MultipedRobotics/multiped/docs/readme.md

# Docs

**work in progress**

## AX-12A Quadruped

All current efforts is going into this version.

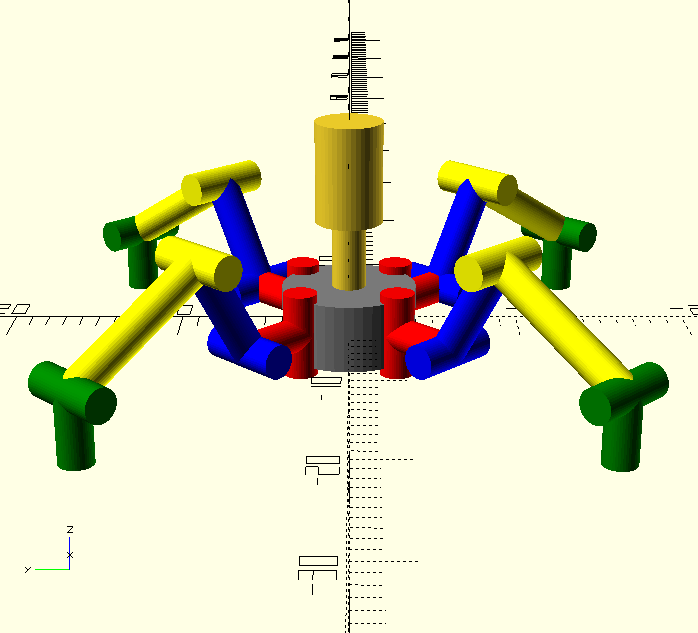
[picture p5: docs/quad-4-links.png]


## XL-320 Quadruped

**work pretty much abandoned**

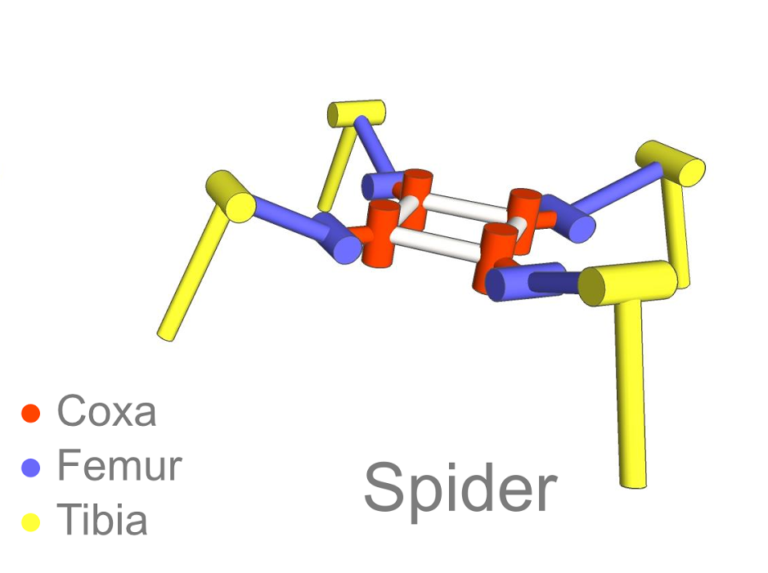
[picture p6: docs/spider.png]
