MultipedRobotics/multiped/docs/misc/readme.md

# Documentation

**This is still a work in progress**

This folder contains most of the documentataion for this robot. Other documents would
include the libraries used:

- [mote](https://github.com/MomsFriendlyRobotCompany/mote): how the RPi software was setup
- [opencvutils](https://github.com/MomsFriendlyRobotCompany/opencvutils): for the pi camera
- [xl-320](https://github.com/MomsFriendlyRobotCompany/pyxl320): the servos used in the legs
- [ins_nav](https://github.com/MomsFriendlyRobotCompany/ins_nav): navigation software
- [nxp_imu](https://github.com/MomsFriendlyRobotCompany/nxp_imu): inertial measurement unit
- [mcp3208](https://github.com/MomsFriendlyRobotCompany/mcp3208): analog to digital converter
- [fake_rpi](https://github.com/MomsFriendlyRobotCompany/fake_rpi): library to emulate the RPi when testing on different hardware (like my macbook)

## Documentation Here

- Markdown: documentation about this robot that is not already covered above
- ipython: jupyter notebooks for software development

Other folders contain various information
