MultipedRobotics/multiped/docs/misc/walking-robots-pdfs/equations-for-hexapod-robot-control.pdf

Equations for hexapod robot control | www.hexapod-kit.com

# Equations for Hexapod robot control

Determine joints angles according to the position of leg tip. A method for linear interpolation (straight walk).
A method for circular interpolation (curved walk).
A method for body inclination (tilt).

Determine joints angles according to the position of leg tip.

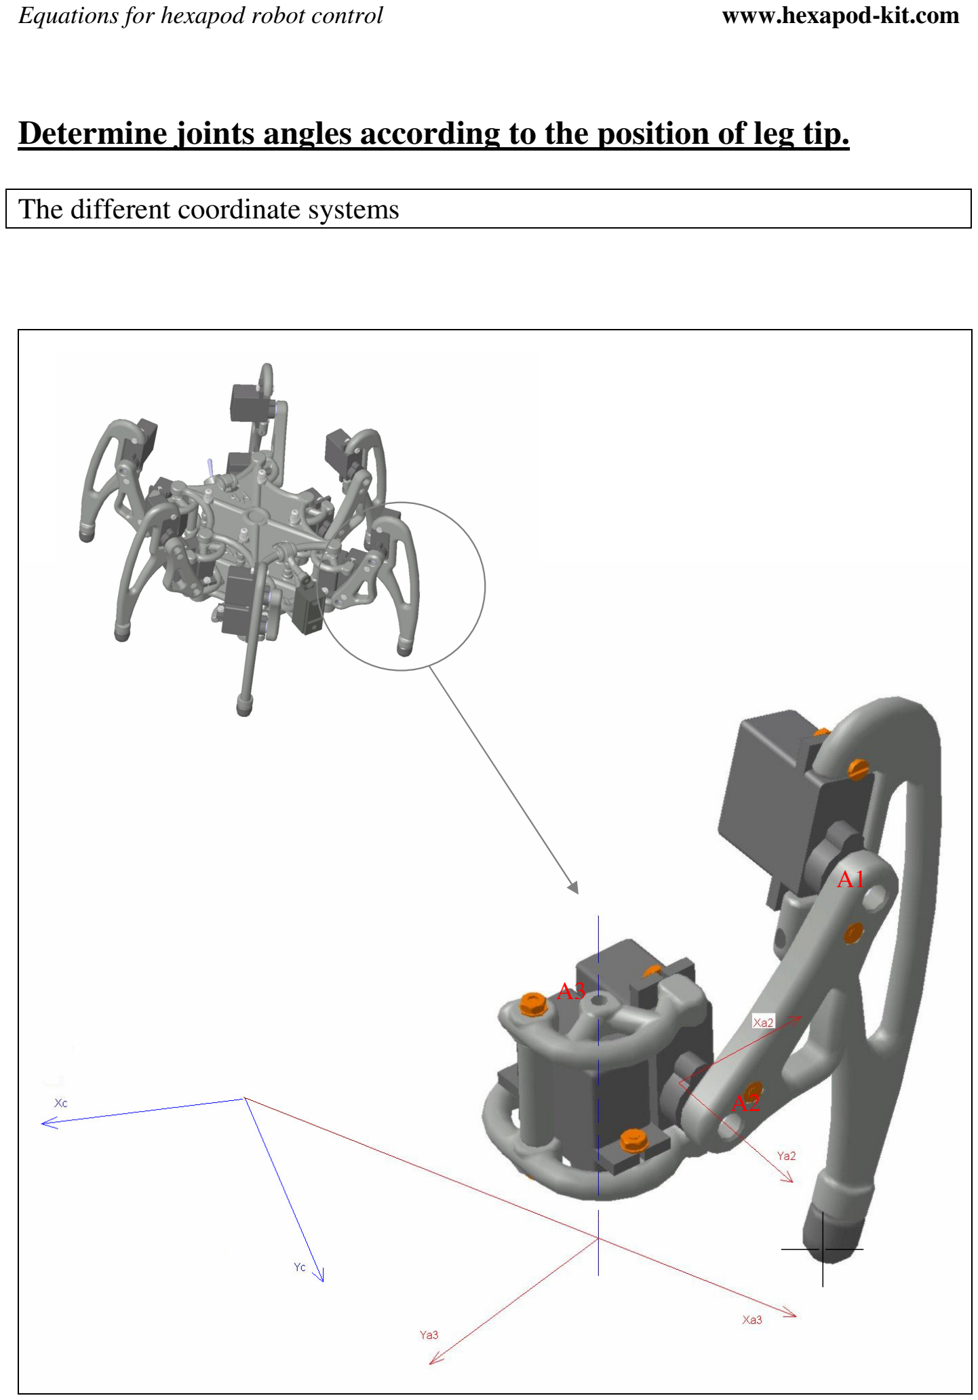
[picture p13: page 2]

The different coordinate systems

A1

A2

A3

We want to drive the tip of a leg by its coordinates in a Cartesian coordinate system.
For reasons of simplicity, we express the coordinates in a fixed coordinate system centred on the body of the hexapod.
To calculate the angles to be applied to the three joints of the leg we have to use different coordinate systems, either fixed or movable relative to the body.
All angle measurements in formulas are expressed in radians.
- Coordinate systems fixed to the body c et a3 :

Seen from above

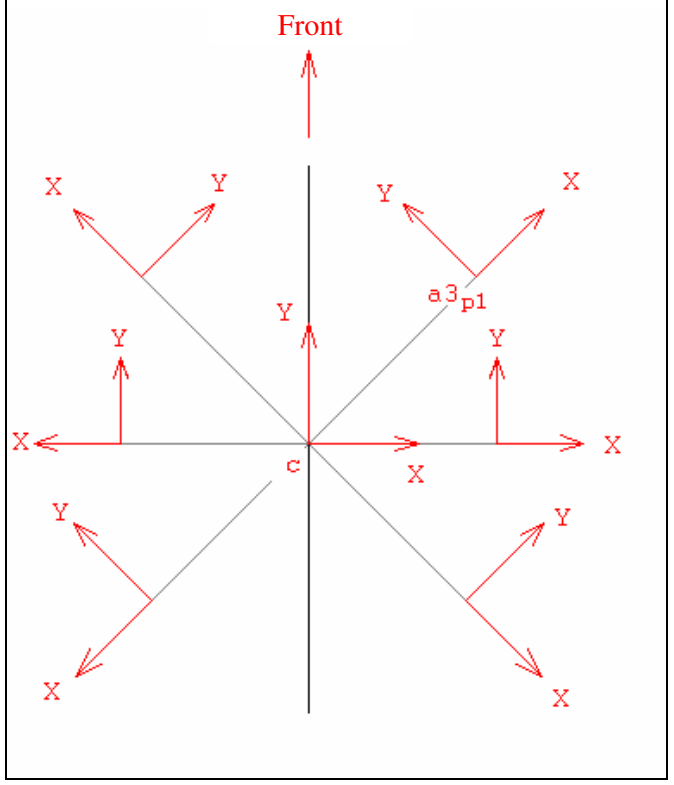
[picture p14: figure]
Front

System c is centred on the robot body. The plan [XY] of the system coincides with the underside of the body (the lowest point).
Systems a3px are centred on A3 joints of each leg.

- Coordinate systems movable relative to the body a2:

Seen top

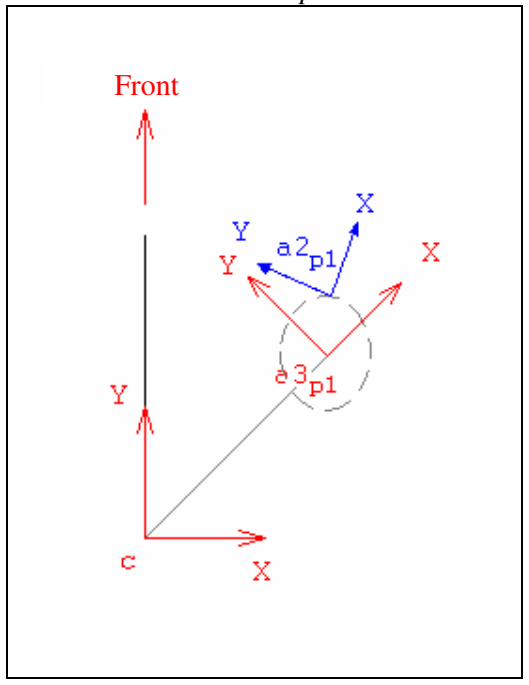
[picture p15: figure]
Front

Joints A2 and A1 in the [XZ] plan of coordinate system a2 :

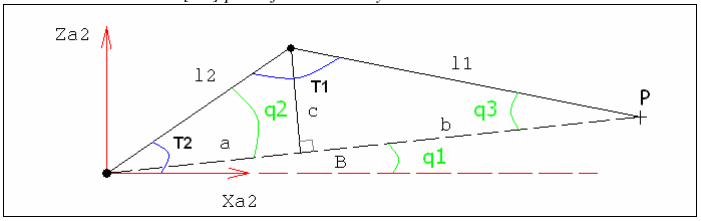
[picture p16: figure]

Given :

- l1et l2 respectively the lengths of the extreme and middle phalanxes.
- T1 angle between the extreme phalanx and middle phalanx.
- T2 angle between X axis and the middle phalanx.
- q1 angle between the axis X and B imaginary line passing through the joint centre A2 and the point P.
- q2 angle between B and the middle phalanx.
- q3 angle between B and the extreme phalanx.

B = a + b
2 | 2 | 2 B = Pxa2 + Pza2

2

cos( )2
l

a
q =

T 2 = q1+ q2

Find T2

B

B | l | l
a
B | aB | l | l
a | B | a | aB | l | l
a | B a | l | l
a | b | l | l
b | l | c
a | l | c

2

2 1

2 | 2 | 1
( | 2 | ) | 2 | 1
( | ) | 2 | 1

2 1

1

2

2 | 2 | 2
2 | 2 | 2
2 | 2 | 2 | 2 | 2
2 | 2 | 2 | 2
2 | 2 | 2 | 2
2 | 2 | 2
2 | 2 | 2
+ | −
=
− | + | = | −
− | + | − | = | −
− | − | = | −
− | = | −
= | −
= | −
l | B
B | l | l
q
2* 2*

2 1
cos( )2
2 | 2 | 2
+ | −
= | )
2

2
) arctan(
2* 2*

2 1

### 2 arccos(

2 | 2 | 2

Pxa

Pza
l | B
B | l | l
T | +
+ | −
=

)
2

2

### 1 arctan(

Pxa

Pza
q =

B

B | l | l
a
| 2 | 2 1
2 | 2 | 2
+ | −
=

cos(a −b) = cos(a)cos(b) + sin(a)sin(b)

Find T1

2 1 2

2 1
2 1 2
2 2 | 2 | 1
cos( )1
| | 2 1 2 2 2
2 1 2
| 2 1
cos( )1

1 2 1 2

2
1 2

2
cos( )1

1 2

2 | ( ( | ))
2
2 | ( | )
cos( )1

1 2

2
1 2

cos( )1

1 1 2

*
2

cos( )1

1 1 2

*
2

cos( )1

1 1 2

1
*
2

2
cos( )1

1 1 2

* 1
2

cos( )1 1

1 2

))
1

*) arcsin(
2

cos( )1 cos(arcsin(

)
1

) arcsin(
2

### 1 arcsin(

) )
1

) arcsin(
2

1 ( arcsin(

)
1

) arccos(
2

### 1 arccos(

1 | 2 | 3
2 | 2 | 2 | 2 | 2 | 2 | 2
2 | 2 | 2 | 2

2 2

2

2

2 2

2 | 2 | 2

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
l | l | B
l l
l | B | l | l
T

ll

l
ll
B | l | l
T

ll

aB
ll

l
ll

l aB T

ll

l a a b
l
l | a | ab T

ll

l | a | ab
ll

c ab T

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
T | q | q
+ | −
=
− | − | +
=
| | +
+ | −
= −
= | −
− | +
= −
− | + | +
= −

− −
=

− +
=

+
=
= | +
= | +

+

− | −
=
= | − | − | +
= | +
= | −
= | − − | + | +
= | − | −
= | − | −
π | π

π

π

)
2 1 2

1 2

### 1 arccos(

2 | 2 | 2

l l

l | l | B
T

+ −
=

Find joint angle A3 (T3)

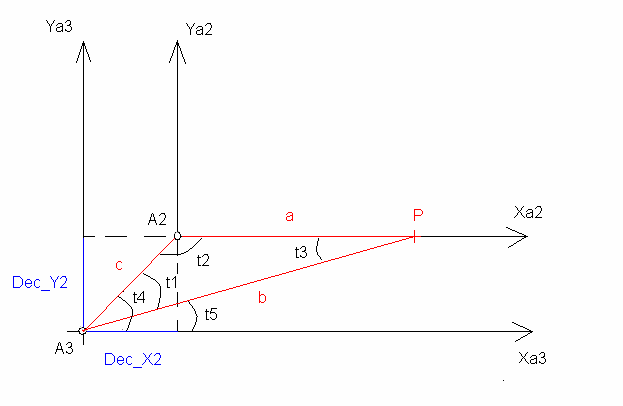
[picture p17: figure]

- Dec_X2 is the offset on X axis, between joints A3 et A2.
- Dec_Y2 is the offset on Y axis, between joints A3 et A2.
- Dec_Z2 is the offset on Z axis, between joints A3 et A2 (=0).
- Given a the projection on Xa2 of the imaginary line B (seen previously).

2 2

2 2

3 3

)
_ 2

_ 2
arctan(
2

2

_ 2 | _ 2
b | Pxa | Pya Dec Y

Dec X
t
c | Dec X | Dec Y
= | +
= | +
= | +

π

We know that :

sin( )1 | sin( )2 | sin(t )3 c
| t

b
t

a
= | = | Sinus proportionality rule.

So :

sin( )2 | cos( )2 )

sin( )2
1 2 arcsin(

)

sin( )2

### 3 arcsin(

2 | 2 | 2
a | b | c | t | c | t

b

c | t
t | t

b

c t
t
= | − | × | + ×

×
= | − | −
| | ×
=

π

2 | sin( )2 | cos( )2
2 | 2 | 2 Pxa = Bx = b − c × | t | + c × | t

Pya2 = 0

)
3

3

### 5 arctan(

)

sin( )2

### 1 arcsin(

)
_ 2

_ 2

### 4 arctan(

Pxa

Pya
t

b

a t
t

Dec X

Dec Y
t

=

×
=

=

Given T3 the angle of the joint A3, we have :

T3 = t5 + t1− t4

Change of coordinate system (system c to a3)

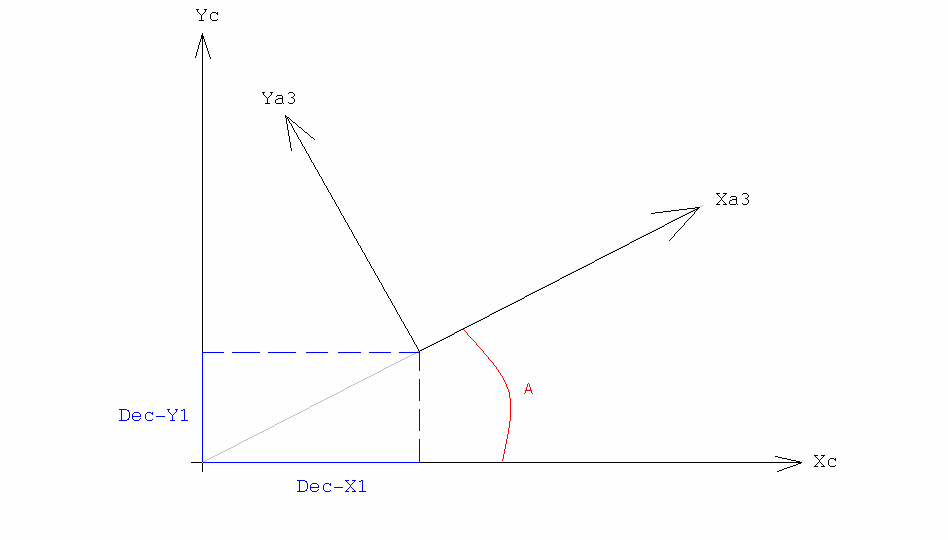
[picture p18: figure]

- System a3 is centred on A3 joint.
- System c is centred on the hexapod body (Y axis pointing to the front of the hexapod).
- A is the angle between X axis of the body centred system and the X axis of the A3 joint centred system.
- Dec_X1 is the abscissa of a3 system centre, expressed in the c system.
- Dec_Y1 is the ordinate of a3 system centre, expressed in the c system.
- Dec_Z1 is the altitude of a3 system centre, expressed in the c system (=0).

A, Dec_X1, Dec_Y1 et Dec_Z1 are not the same for all legs.

3 | ( | cos( ) | sin( ))
3 | cos( ) | sin( ) | _ 1 | _ 1

2 2

Pya | Pyc | A | Pxc | A
Pxa | Pxc | A | Pyc | A | DEC X | DEC Y
= − | × | − | ×
= | × | + | × | − | +

Sum up

Coordinate system c to a3 :

### 3 _ 1

3 | ( | cos( ) | sin( ))
3 | cos( ) | sin( ) | _ 1 | _ 1

2 2

Pza | Pzc Dec Z
Pya | Pyc | A | Pxc | A
Pxa | Pxc | A | Pyc | A | DEC X | DEC Y
= | −
= − | × | − | ×
= | × | + | × | − | +

Coordinate system a3 to a2 :

2 | 3 | _ 2

2 0

2 | sin( )2 | cos( )2
| ) _ 2

_ 2
arctan(
2

2

3 3

_ 2 | _ 2
2 | 2 | 2

2 2

2 2

Pza | Pz | Dec Z

Pya

Pxa | Bx | b | c | t | c | t
| | | Dec Y

Dec X
t
c | Pxa | Pya
b | Dec X | Dec Y
= | −

=

= | = | − | × | + ×
= | +
= | +
= | +

π

Joints angles :

2 2 B = Pxa2 + Pza2

)
2 1 2

1 2

### 1 arccos(

2 | 2 | 2

l l

l | l | B
T

+ −
=

)
2

2
) arctan(
2* 2*

2 1

### 2 arccos(

2 | 2 | 2

Pxa

Pza
l | B
B | l | l
T | +
+ | −
=

)
_ 2

_ 2
) arctan(
3 3

))
_ 2

_ 2
arctan(
2

sin(
) arcsin(
3

3

### 3 arctan(

2 | 2 | Dec X Dec Y
Pxa | Pya
| Dec Y

Dec X
a

Pxa

Pya T | −

+

× | +
= | +

π

A method for linear interpolation (straight walk).

Straight walking consist in moving with a given distance in a given direction with a given step.

The three method parameters are :

L : The distance.
A : Angle between walking direction and the longitudinal axis of the hexapod (Yc). P : The unitary step of the leg (linear distance made in one walking cycle).

Another parameter is also used :

G : The ground clearance (body to ground distance).

Example for leg n°1

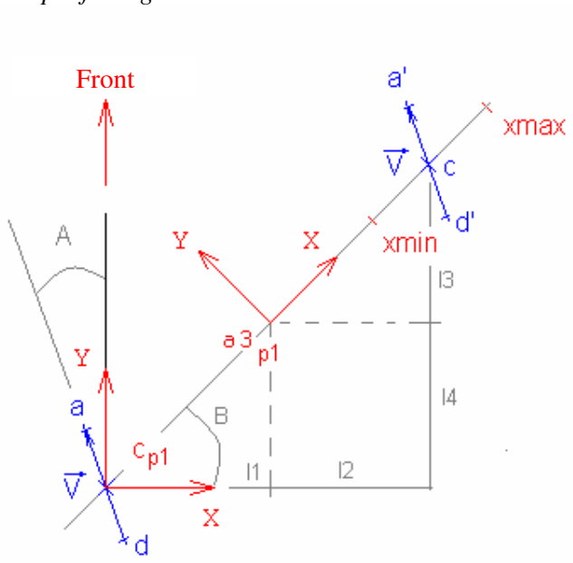
[picture p19: figure]
Front

Given V

r
the vector which norm is equal to L, and which angle with Yc axis is A .

### 4 _ 1

)
2

max min 3 sin( ) ( min

)
2

max min 2 cos( ) ( min

### 1 _ 1

l | Dec Y
x | x
l | B | x
x | x
l | B | x
l | Dec X

=

−
= | × | +

−
= | × | +

=

Coordinates of starting and arrival points d et a expressed in cp1 system.

dy | ay
dx | ax

L
ay | A

L
ax | A

= −

= −

= | ×
= − | ×

2

cos( )

2

sin( )

Coordinates of starting and arrival points d’ et a’ translated on c point expressed in cp1 system.

' | 3 | 4
' | 1 | 2
' | 3 | 4
' | 1 | 2
d y dy l | l
d x dx l | l
a y ay l | l
a x ax l | l
= | + | +
= | + +
= | + | +
= | + +

Then, we are able to calculate the values of the different joints for starting and arrival point thanks to the previous formulas.

Remarks :

Leg movement vector points in the opposite direction to the wanted body movement vector.

Number of cycles to be performed to reach the distance is equal to
P

L

In cp1 system Z coordinate of the leg tip is equal to –G.

A method for circular interpolation (curve walk).

Curve walking consists in moving of a given angle on a circle of given centre with a given step.

The three method parameters are :

A : Rotation angle.
C(xc;yc) : Coordinates of the rotation centre.
P : Unitary step of the leg (linear distance made in one walking cycle).

Another parameter is also used :

G : The ground clearance (body to ground distance).

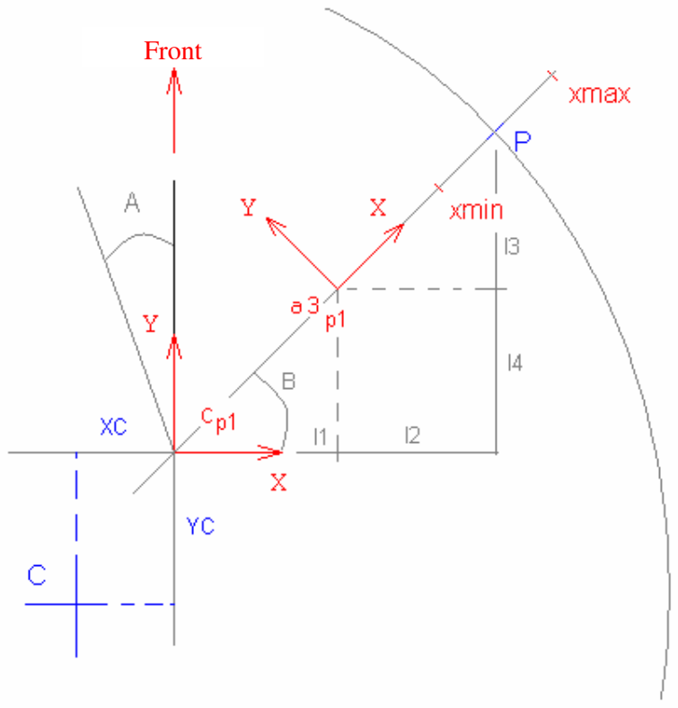
[picture p20: figure]
Front

### 4 _ 1

)
2

max min 3 sin( ) ( min

)
2

max min 2 cos( ) ( min

### 1 _ 1

l | Dec Y
x | x
l | B | x
x | x
l | B | x
l | Dec X

=

−
= | × | +

−
= | × | +

=

Compared to straight walking not all legs have the same movement vector. For a given unitary angular step, the farthest leg from the rotation centre will describe the longest distance in one walking cycle (Equal to P in our case).

At first we have to determine which leg is the farthest from the rotation centre.
For each leg we calculate the length of CP segment :
( | ) ( | ) ² | 2
CP = | l1+ l2 − XC + l3 + l4 −YC

For the leg which have the maximal CP, we calculate the angle T represented by points a and d spaced of a distance P, belonging to the circle.

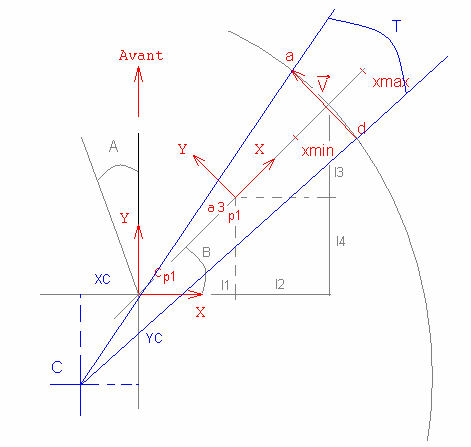
[picture p21: figure]

CP

P
T

Circ

P
T
Circ | CP

=

× ×
=

= × ×

π

π
2

2

T will be the unitary angular step for all legs in order to respect the unitary linear step P.

In the coordinate system centred on the cercle we express :

- The angle between the starting point d and X axis :
( | )
( | ) | 2

)
1 2

3 4
arctan( | T
l | l | XC
l | l | YC Ad | −
+ | −
+ | −
=
- The angle between the arrival point a and X axis :
( | )
( | ) | 2

)
1 2

3 4
arctan( | T
l | l | XC
l | l | YC Aa | +
+ | −
+ | −
=
- d and a coordinates :
Ya | Aa | CP
Xa | Aa | CP
Yd | Ad | CP
Xd | Ad | CP
= | ×
= | ×
= | ×
= | ×
sin( | )
cos( | )
sin( | )
cos( | )

Now we can calculate the coordinates in the body coordinate system of the starting and arrival movement vector points.

Ya | Aa | CP | YC
Xa | Aa | CP | XC
Yd | Ad | CP | YC
Xd | Ad | CP | XC
= | × | +
= | × | +
= | × | +
= | × | +
(sin( | ) | )
(cos( | ) | )
(sin( | ) | )
(cos( | ) | )

Then, we are able to calculate the values of the different joints for starting and arrival point thanks to the previous formulas.

## A method for body inclination (tilt)

Inclination consists in tilting the body of the robot of a given angle A around the longitudinal axis and a given angle B around the transversal axis.
Thus we must have the six leg extremity belonging to the same plane, tilted of the desired value relative to [XY] body plan.

The three method parameters are :

A : rotation angle around Y.
B : rotation angle around X.
G : The ground clearance (body to ground distance).

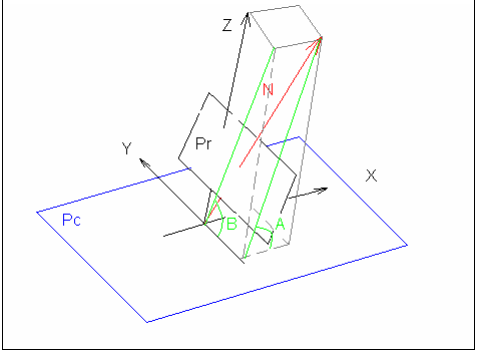
[picture p22: figure]

Calculation of the vector N normal to the Pr plan (tilted plan)

Z | Z | 1

Y Y Z/tan(B)

X X Z/tan(A)

=

=

=
N =

r

Coordinates of the body coordinate system centre projected to the Pr plan, expressed in the body coordinate system.

P = (0;0;-G)

Plane equation.

Given:

N {a,b,c} vector normal to the plan.
A {xa,ya,za} a known point belonging to the plan. M {x,y,z} a point belonging to the plan.
The plan equation is : ax+by+cz - (axa+bya+cza) = 0

If d=(axa+bya+cza) is the constant part of the equation.
In our case d=-G

Calculation of the coordinates of a leg tip in the body coordinate system.

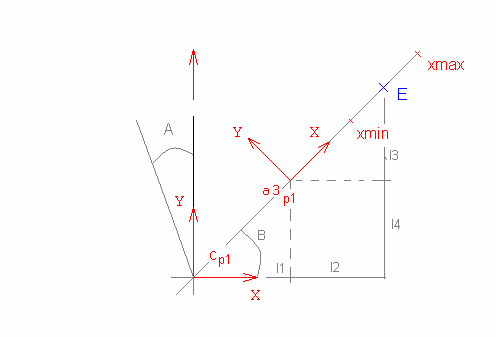
[picture p23: figure]

### 4 _ 1

)
2

max min 3 sin( ) ( min

)
2

max min 2 cos( ) ( min

### 1 _ 1

l | Dec Y
x | x
l | B | x
x | x
l | B | x
l | Dec X

=

−
= | × | +

−
= | × | +

=

)
tan( ) tan( )

(

3 4

1 2

B

Ey
A
Ex Ez | G
Ey l | l
Ex l | l
= − − | −
= | +
= | +

Then, we are able to calculate the values of the different joints for the starting and arrival points thanks to the previous formulas.
