MultipedRobotics/multiped/docs/multiped/1-Figure1-1.png

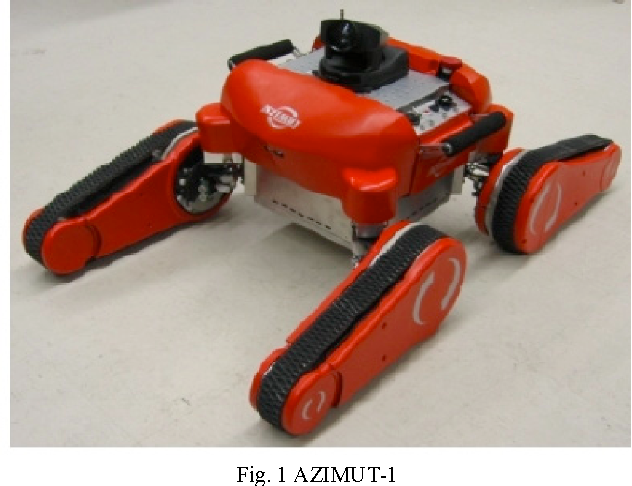
docs/multiped/1-Figure1-1.png
