MultipedRobotics/multiped/docs/multiped/2-Figure2-1.png

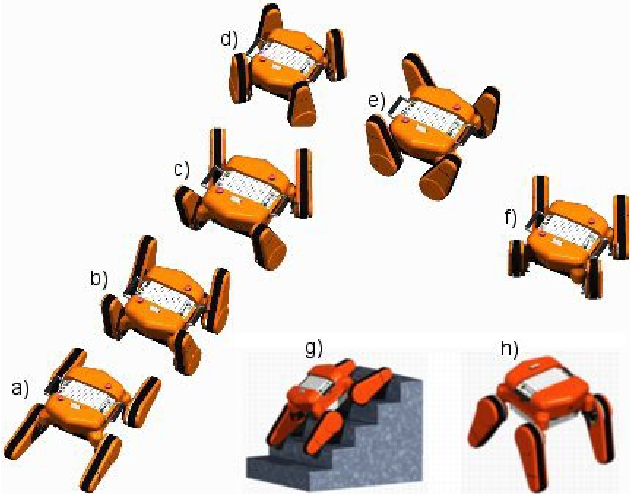
docs/multiped/2-Figure2-1.png
