MultipedRobotics/multiped/docs/multiped/3-Figure1-1.png

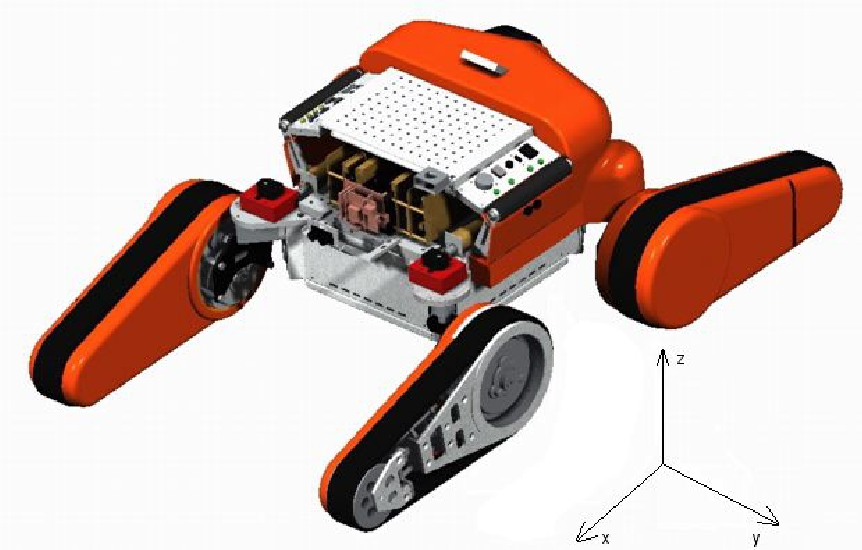
docs/multiped/3-Figure1-1.png
