MultipedRobotics/multiped/docs/multiped/9-Figure9-1.png

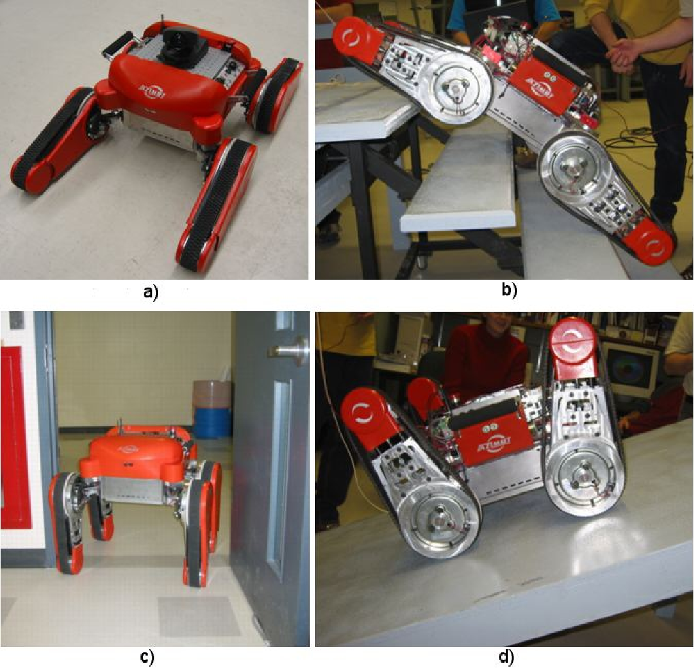
docs/multiped/9-Figure9-1.png
