MultipedRobotics/multiped/docs/multiped/200px-AZIMUTMulti.jpg

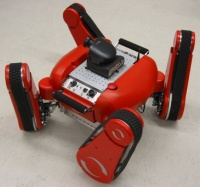
docs/multiped/200px-AZIMUTMulti.jpg
