MultipedRobotics/multiped/docs/multiped/AZIMUT-hybrid-robot.png

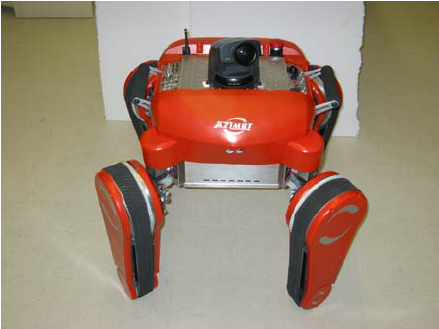
docs/multiped/AZIMUT-hybrid-robot.png
