MultipedRobotics/multiped/docs/multiped/img_1182.jpg

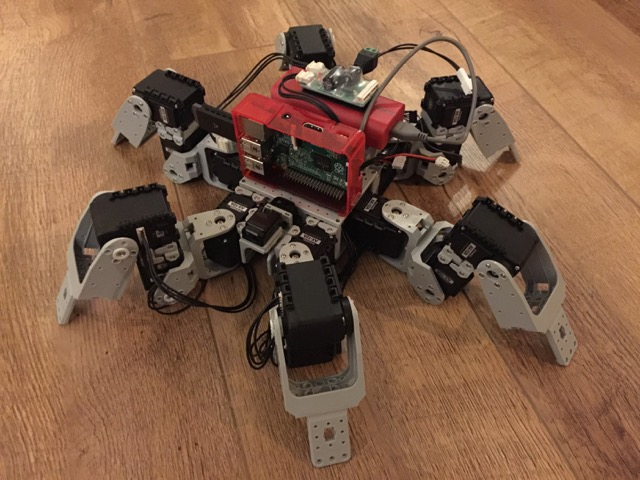
docs/multiped/img_1182.jpg
