MultipedRobotics/multiped/docs/multiped/robot18.jpg

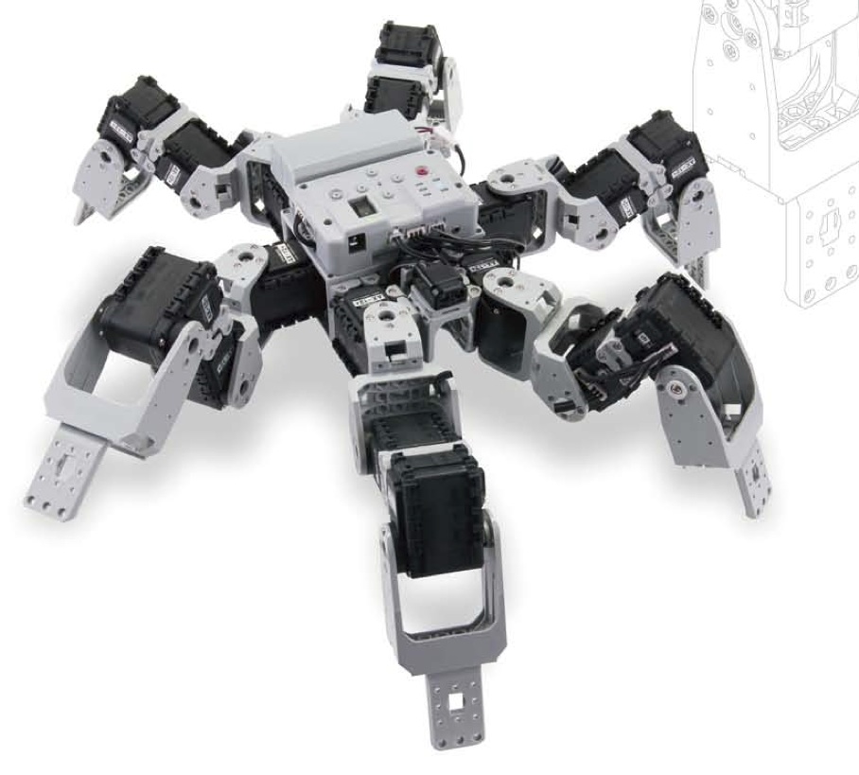
docs/multiped/robot18.jpg
