MultipedRobotics/multiped/ax12/electrical/power-supply/stl/iec_cover_lrs350_v2.stl

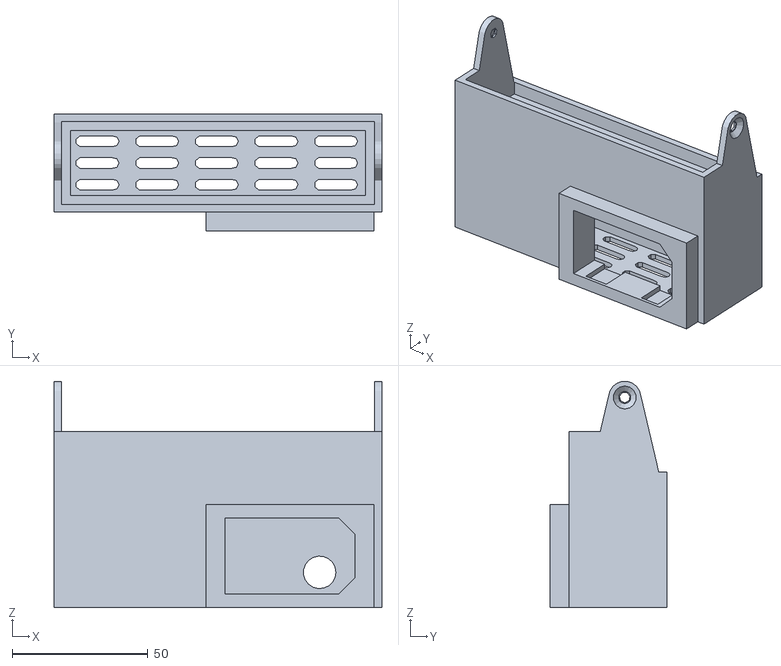
[picture p32: CAD file, 2018-05-07]
ax12/electrical/power-supply/stl/iec_cover_lrs350_v2.stl
121.0 x 43.0 x 83.4
