MultipedRobotics/multiped/(commit log)

2017-07-10 update ... added hardware
    [femur_SLA.STL, frame_adaptor.stl, leg.stl, parts.scad, parts.stl, pully.stl, test.obj, tibiaLong_SLA.STL]
2017-12-25 reorg ... test still fail
    [test_leg.py]
2018-02-04 hardware updates
    [PiZero_1.2.scad, PiZero_1.2.stl, bottom-plate.stl, leg.stl, middle-plate.stl, parts.scad, parts.stl, test.obj]
2018-02-04 fix build script
    [base_plate.scad, base_plate.stl, bottom-plate.stl, common.scad, main_plate.scad, main_plate.stl, middle-plate.stl, misc.scad]
2018-02-23 new base
    [ax12-base.stl, leg.scad]
2018-03-03 removed serial port kicad files
    [serial-B.Cu.gbr, serial-B.Mask.gbr, serial-B.SilkS.gbr, serial-Edge.Cuts.gbr, serial-F.Cu.gbr, serial-F.Mask.gbr, serial-F.SilkS.gbr, serial-NPTH.drl]
2018-03-05 hw updates
    [leg.scad, new-bottom.stl, new-femur-2.stl, new-top.stl, parts.scad, sternum.scad]
2018-03-08 jst library
    [robot.sch]
2018-03-09 electrical update
    [robot.kicad_pcb, robot.sch]
2018-03-09 new hw
    [common.scad, femur.scad, head.scad, new-head-2.scad, new-head-2.stl, new-head.scad]
2018-03-11 small fix
    [robot-B.Cu.gbr, robot-B.Mask.gbr, robot-B.SilkS.gbr, robot-Edge.Cuts.gbr, robot-F.Cu.gbr, robot-F.Mask.gbr, robot-F.SilkS.gbr, robot-NPTH.drl]
2018-03-12 new power board
    [robot-B.Cu.gbr, robot-B.Mask.gbr, robot-B.SilkS.gbr, robot-Edge.Cuts.gbr, robot-F.Cu.gbr, robot-F.Mask.gbr, robot-F.SilkS.gbr, robot-NPTH.drl]
2018-03-16 new new power board
    [robot-B.Cu.gbr, robot-B.Mask.gbr, robot-B.SilkS.gbr, robot-Edge.Cuts.gbr, robot-F.Cu.gbr, robot-F.Mask.gbr, robot-F.SilkS.gbr, robot-NPTH.drl]
2018-03-17 power 3 done :tada: :electric_plug:
    [robot-B.Cu.gbr, robot-B.Mask.gbr, robot-B.SilkS.gbr, robot-Edge.Cuts.gbr, robot-F.Cu.gbr, robot-F.Mask.gbr, robot-F.SilkS.gbr, robot-NPTH.drl]
2018-03-24 new head
    [new-head-4.scad]
2018-03-26 new leg design
    [femur.scad, leg.scad]
2018-03-29 curved leg
    [coxa-l.stl, coxa-r.stl, leg.scad]
2018-03-30 new tarsus
    [leg.scad, tarsus2.stl]
2018-04-02 new leg
    [common.scad, coxa.scad, coxa.stl, femur.scad, leg.scad, misc.scad, pi.scad, robotis_parts.scad]
2018-04-02 re-org and clean up :tada:
    [coxa-bottom.stl, coxa-r.stl, coxa-top.stl, coxa.scad, coxa.stl, femur.scad, femur.stl, head.scad]
2018-04-09 tibia fix
    [tibia-90-2.stl, tibia.scad]
2018-04-10 new power board v4
    [robot-B.Cu.gbr, robot-B.Mask.gbr, robot-B.SilkS.gbr, robot-Edge.Cuts.gbr, robot-F.Cu.gbr, robot-F.Mask.gbr, robot-F.SilkS.gbr, robot-NPTH.drl]
2018-04-19 power board
    [power.scad]
2018-04-22 update - 1 leg working
2018-04-23 new tibia
    [tibia-4.stl, tibia.scad]
2018-04-23 clean out stl
    [bottom.stl, coxa.stl, femur.stl, new-femur-2.stl, new-femur.stl, new-head-2.stl, new-tibia-2.stl, power.scad]
2018-04-30 working new head and power
    [power.scad]
2018-05-06 another new deck ... I think I like this :tada:
    [power.scad, sternum-2.scad]
2018-05-07 new design :tada:
    [power.scad, robot-2.scad, sternum-2.scad]
2018-05-09 new power board :electric_plug:
    [robot-B.Cu.gbr, robot-B.Mask.gbr, robot-B.SilkS.gbr, robot-Edge.Cuts.gbr, robot-F.Cu.gbr, robot-F.Mask.gbr, robot-F.SilkS.gbr, robot-NPTH.drl]
2018-05-09 test interface
    [sternum-2.scad, test-interface.stl]
2018-05-10 the stand
    [stand.stl, sternum-2.scad]
2018-05-15 pcb updates
    [robot.kicad_pcb, robot.sch]
2018-06-10 power version 5 done and reorg
    [robot-B.Cu.gbr, robot-B.Mask.gbr, robot-B.SilkS.gbr, robot-Edge.Cuts.gbr, robot-F.Cu.gbr, robot-F.Mask.gbr, robot-F.SilkS.gbr, robot-NPTH.drl]
2018-08-26 more parts :bento:
    [bottom-rect-2.stl, bottom-rect-4.stl, lidar_base.stl, new-bottom.stl, new-top.stl, power.scad, robot-2.scad, rpi_base.stl]
2018-08-29 lidar base update v3 :smile:
    [lidar_base-3.stl, robot-2.scad]
2018-08-30 new pi base
    [robot-2.scad, rpi_base-2.stl]
2018-08-31 updated pi board
    [robot-B.Cu.gbr, robot-B.Mask.gbr, robot-B.SilkS.gbr, robot-Edge.Cuts.gbr, robot-F.Cu.gbr, robot-F.Mask.gbr, robot-F.SilkS.gbr, robot.drl]
2018-08-31 rpi board update :bento:
    [robot-B.Cu.gbr, robot-B.Mask.gbr, robot-B.SilkS.gbr, robot-Edge.Cuts.gbr, robot-F.Cu.gbr, robot-F.Mask.gbr, robot-F.SilkS.gbr, robot.drl]
2018-09-17 camera bracket
    [camera-mount.scad, camera-mount.stl]
2018-09-17 new base with camera mount
    [robot-2.scad, rpi_base-3.stl]
2018-09-17 updated pi base :tada: :taco:
    [robot-2.scad, rpi_base-4.stl]
2018-09-23 moded head
    [base.scad, robot-2.scad, robot.scad, sternum-2.scad, sternum.scad]
